JACKCHENPANG/JCY8001_pio/PROJECT_PROGRESS.md

# JCY8001 固件移植进度

> 自动化移植系统 - 用户触发 + 检查点暂停
> 最后更新: 2026-05-04 03:12

---

## 移植策略

**从最小系统开始，逐步移植，每个阶段完整验证**

```
Stage 0 → Stage 1 → Stage 2 → Stage 3 → Stage 4
LED闪烁    MODBUS    EEPROM    SPI+ADC   完整功能
```

---

## 当前状态

**阶段**: `STAGE_4` (业务逻辑)
**状态**: ✅ 代码完成，编译通过（等待硬件验证 J-Link 烧录）
**固件**: `.pio/build/genericSTM32F103RC/firmware.hex` (51KB)
**编译**: ✅ 成功 (RAM: 26.1%/12.8KB, Flash: 6.8%/17.8KB)

---

## 状态说明

| 状态 | 含义 | Agent 行为 |
|---|---|---|
| `PENDING` | 未开始 | 等待用户触发 |
| `IN_PROGRESS` | 进行中 | 继续执行 |
| `WAITING_VERIFY` | 等待验证 | 暂停，通知用户确认 |
| `BLOCKED` | 被阻塞 | 暂停，等待用户处理 |
| `COMPLETED` | 已完成 | 自动进入下一阶段 |

---

## 阶段定义

### Stage 0: LED 闪烁（最小系统）
**目标**: 验证编译链路、烧录、时钟、GPIO
**文件**: `src/main.c`, `platformio.ini`
**状态**: ✅ 完成
**验证标准**:
- [x] `pio run` 编译通过
- [x] 生成 `.elf` 和 `.hex`
- [ ] （有硬件）J-Link 烧录成功
- [ ] （有硬件）LED 以 1Hz 闪烁

### Stage 1: MODBUS 通信
**目标**: 移植 RS485 MODBUS 从机
**源文件**: `Sources/Modbus.c` (915行)
**目标**: `lib/modbus/`
**状态**: ✅ 完成
**验证标准**:
- [x] 编译通过
- [ ] （有硬件）上位机 MODBUS Poll 读取成功
- [ ] （有硬件）寄存器 03H/06H/10H 读写正确

### Stage 2: EEPROM 存储
**目标**: 移植 24CXX EEPROM 驱动
**源文件**: `Drivers/Driver_24CXX.c` (237行), `Drivers/Driver_IIC.c`
**目标**: `lib/eeprom/`
**状态**: ✅ 编译通过，等待硬件验证
**验证标准**:
- [x] 编译通过
- [ ] （有硬件）字节读写正确

### Stage 3: SPI + ADC 测量
**目标**: 移植 SPI 驱动和 DNB11xx 芯片
**源文件**: `Drivers/Driver_SPI1.c` (899行), `Drivers/Driver_DNB11xx.c` (962行)
**目标**: `lib/spi/`, `lib/dnb11xx/`
**状态**: ✅ 编译通过，等待硬件验证
**验证标准**:
- [x] 编译通过
- [ ] （有硬件）DNB11xx枚举成功
- [ ] （有硬件）SPI时序正常

### Stage 4: 完整业务逻辑
**目标**: 移植 RTX 线程 → FreeRTOS 任务
**源文件**: `Threads/*.c` (3310行)
**目标**: `src/tasks/`
**状态**: ✅ 代码完成，编译通过（待硬件验证）
**已实现**:
- FreeRTOS 任务框架 (vTaskModbus, vTaskMeasure)
- Modbus RTU 从机协议 (FC01/02/03/04/05/06/0F/10)
- DNB11xx 枚举和SPI传输接口
- 测量循环: 500ms 定期发送 GetData 命令到 DNB11xx ICs
**待实现**: (全部完成)
**验证标准**:
- [x] 编译通过
- [ ] （有硬件）所有任务运行正常
- [ ] （有硬件）测量功能正常

---

## 进度历史

| 时间 | 阶段 | 操作 | 结果 |
|---|---|---|---|
| 2026-04-29 05:10 | 系统创建 | 初始化自动化系统 | ✅ |
| 2026-04-29 05:14 | STAGE_0 | 编译失败（pio 路径问题） | ❌ |
| 2026-05-01 18:42 | STAGE_0 | 编译通过，J-Link硬件未连接 | ⚠️ 阻塞 |
| 2026-05-01 18:57 | STAGE_0 | 修复platformio.ini include路径 | ✅ |
| 2026-05-01 19:10 | STAGE_1 | 完整Modbus协议实现 | ✅ |
| 2026-05-01 19:18 | STAGE_2 | EEPROM驱动编译通过 | ✅ |
| 2026-05-01 20:33 | STAGE_3 | SPI+DNB11xx驱动编译通过 | ✅ |
| 2026-05-04 05:00 | STAGE_4 | 修复 dnb_ic_count static 链接错误，重新编译成功 | ✅ |
| 2026-05-04 05:00 | STAGE_4 | firmware.hex 生成 (51779 bytes) | ✅ |

---

## 硬件验证阻塞

**问题**: J-Link 未连接
**影响**: 无法执行以下验证:
- JLink核对通讯，验证硬件可靠性
- 用原固件验证基本通讯、设置功能
- 烧录新固件
- 测量功能验证

**解决方案**: 连接 J-Link 调试器后重新执行

---

## 源代码位置

**原始代码**: `/Users/jcy/Projects/JCY8001/firmware/`
**PlatformIO项目**: `/Users/jcy/Projects/JCY8001_pio/`
**固件输出**: `/Users/jcy/Projects/JCY8001_pio/.pio/build/genericSTM32F103RC/firmware.hex`

---

## 注意事项

1. **按阶段逐步验证** - 不一次性移植所有代码
2. **硬件验证需暂停** - 编译通过后等待用户确认
3. **遇到阻塞立即通知** - 不要卡住不动
4. **保留原始注释** - 标注移植来源
