JACKCHENPANG/JCY8001_pio/1e-1.png

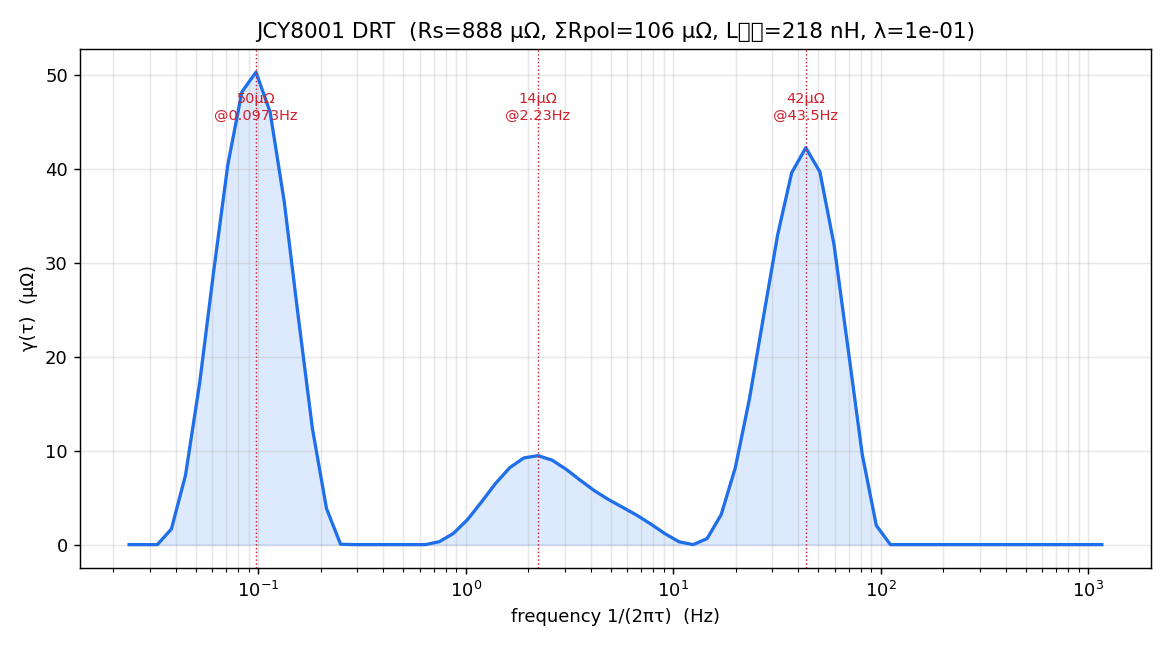
1e-1.png
