JACKCHENPANG/JCY8001_pio/1e-2.png

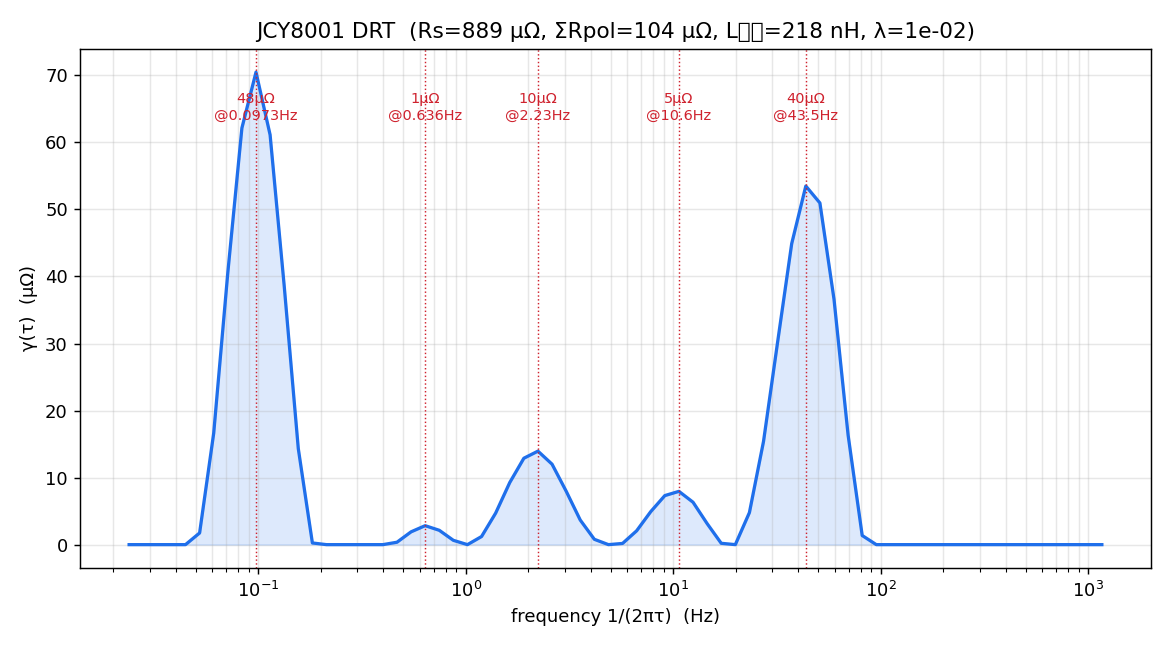
1e-2.png
