JACKCHENPANG/JCY8001_pio/1e-3.png

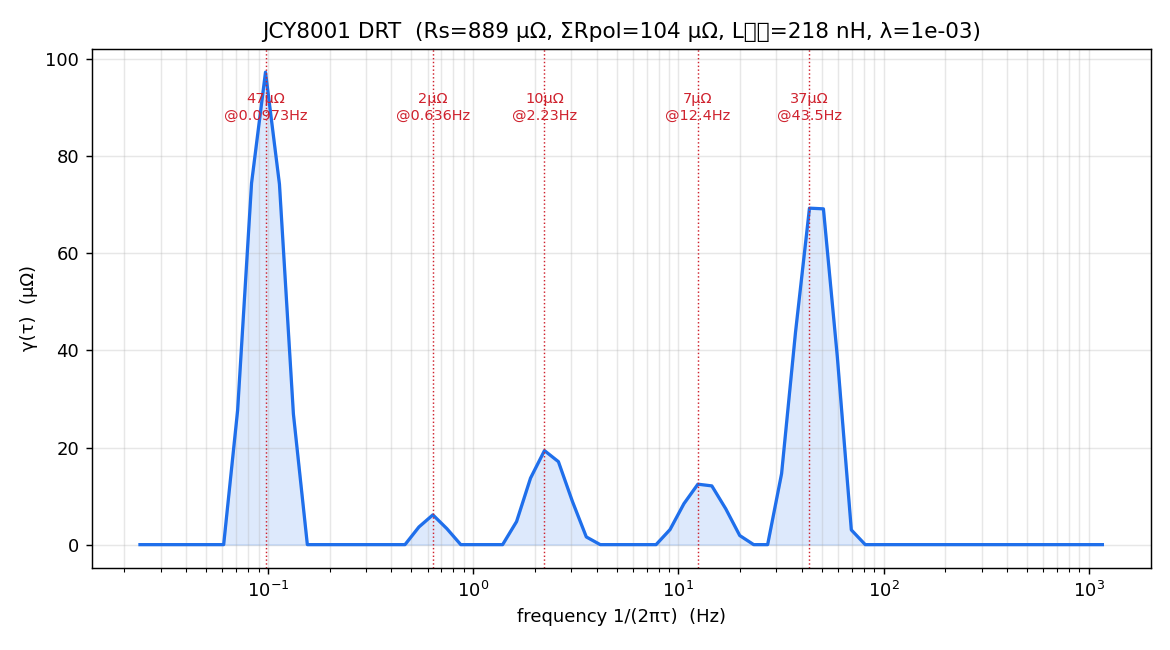
1e-3.png
