JACKCHENPANG/JCY8001_pio/1e-4.png

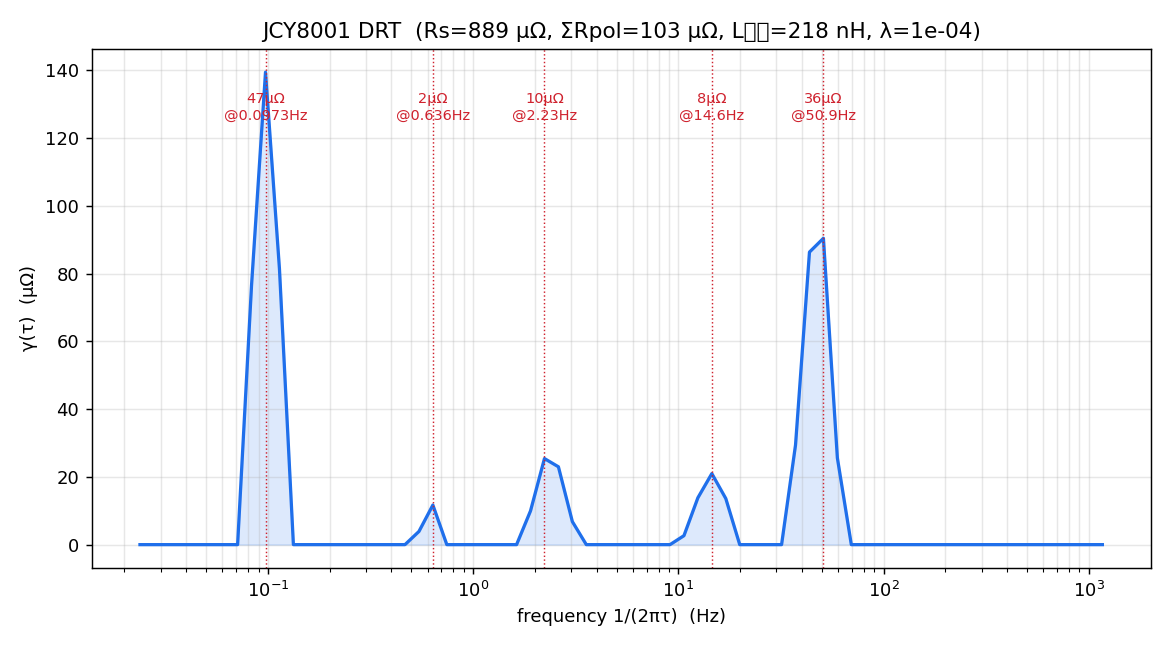
1e-4.png
