JACKCHENPANG/JCY8001_pio/1e-5.png

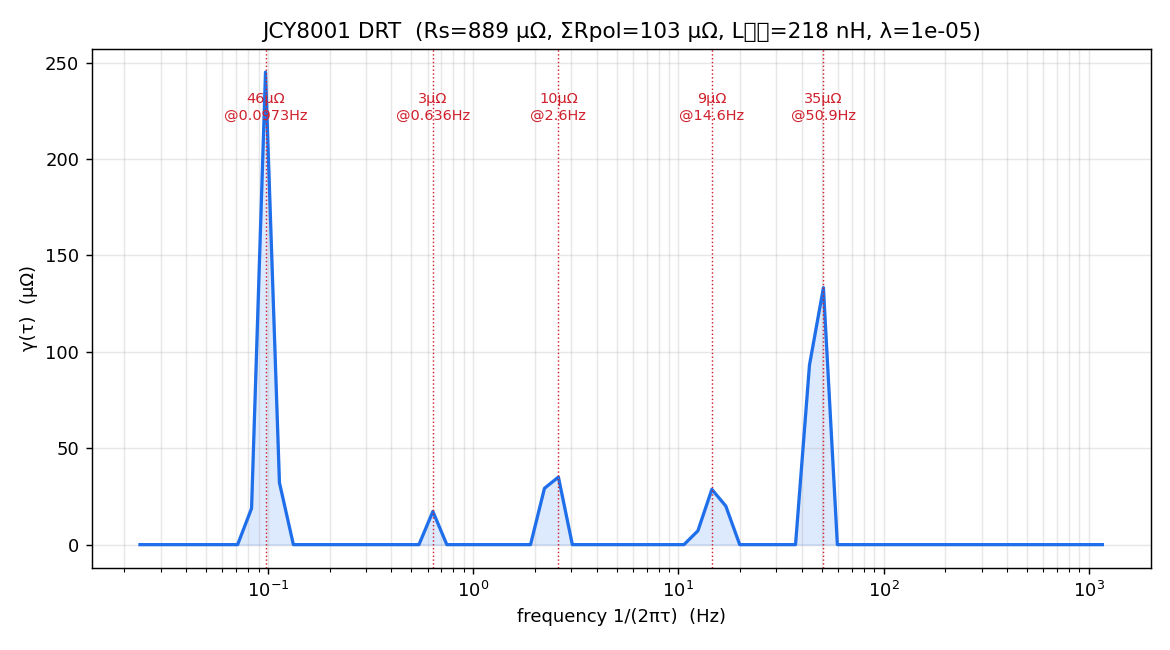
1e-5.png
