JACKCHENPANG/JCY8001_pio/3000.png

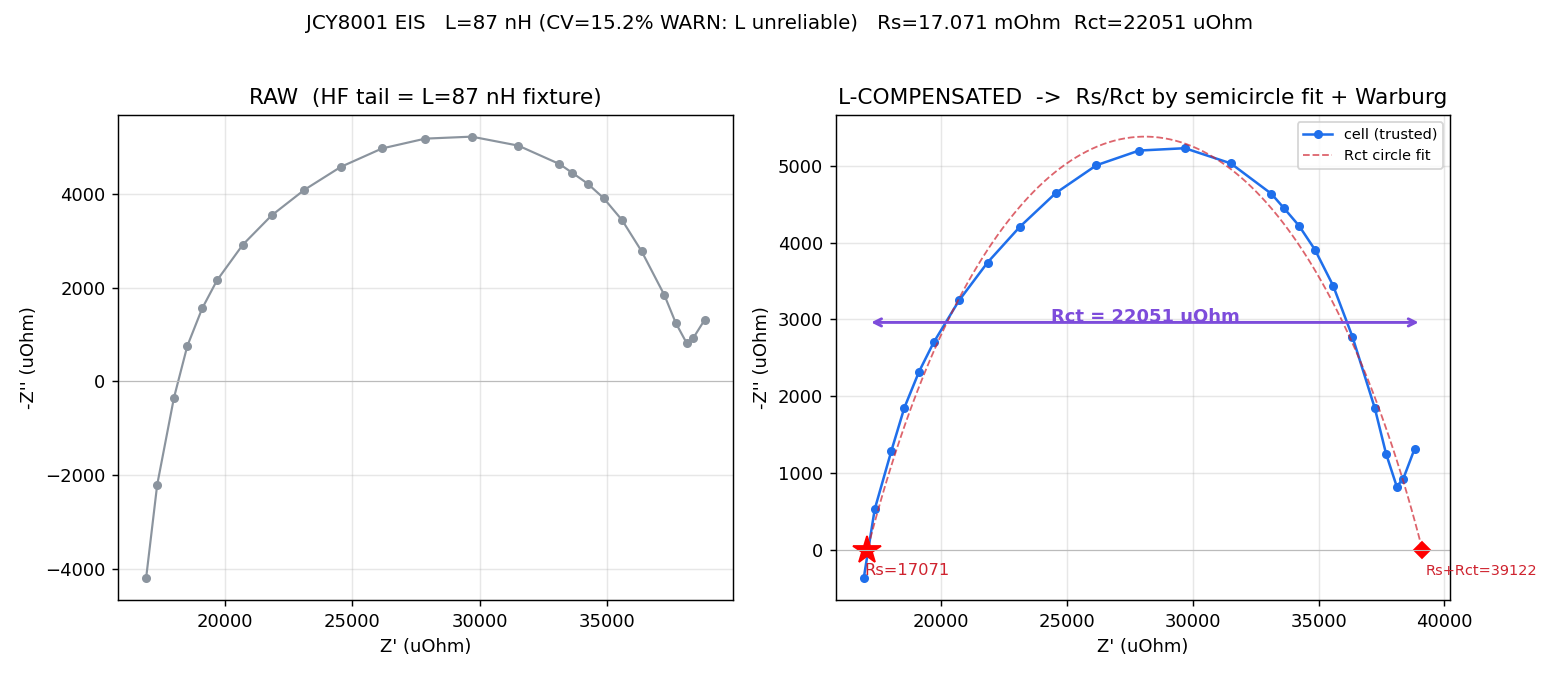
3000.png
