JACKCHENPANG/JCY8001_pio/eis_baseline_1ohm_20260530.png

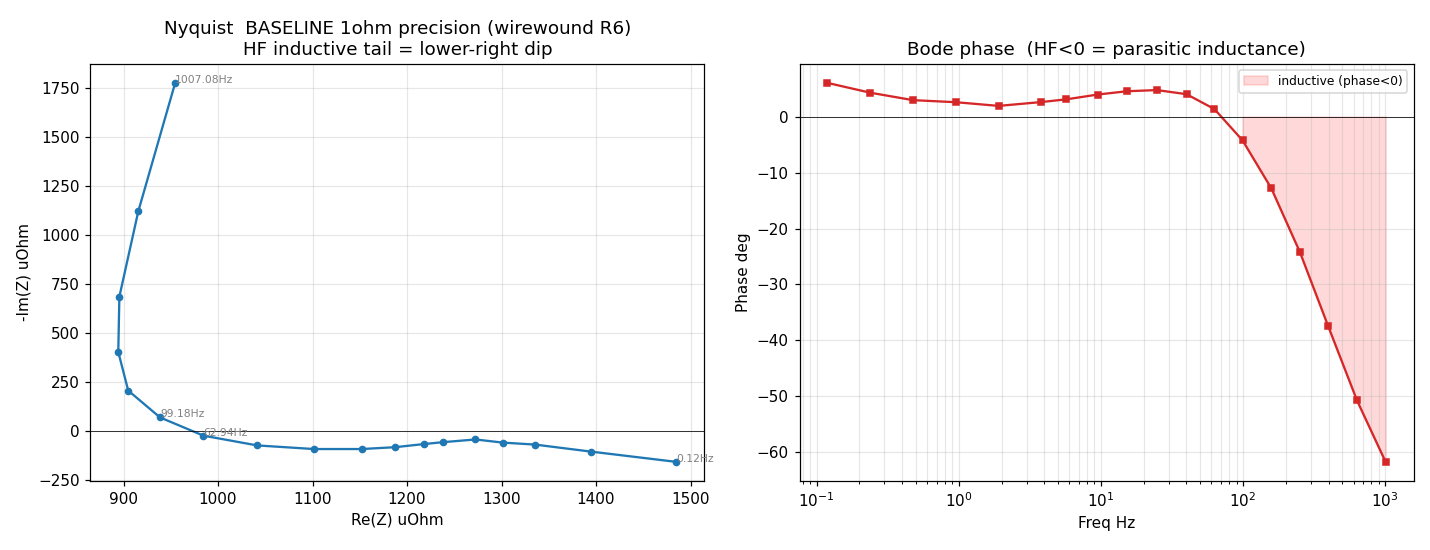
eis_baseline_1ohm_20260530.png
