JACKCHENPANG/JCY8001_pio/eis_compare_20260530.png

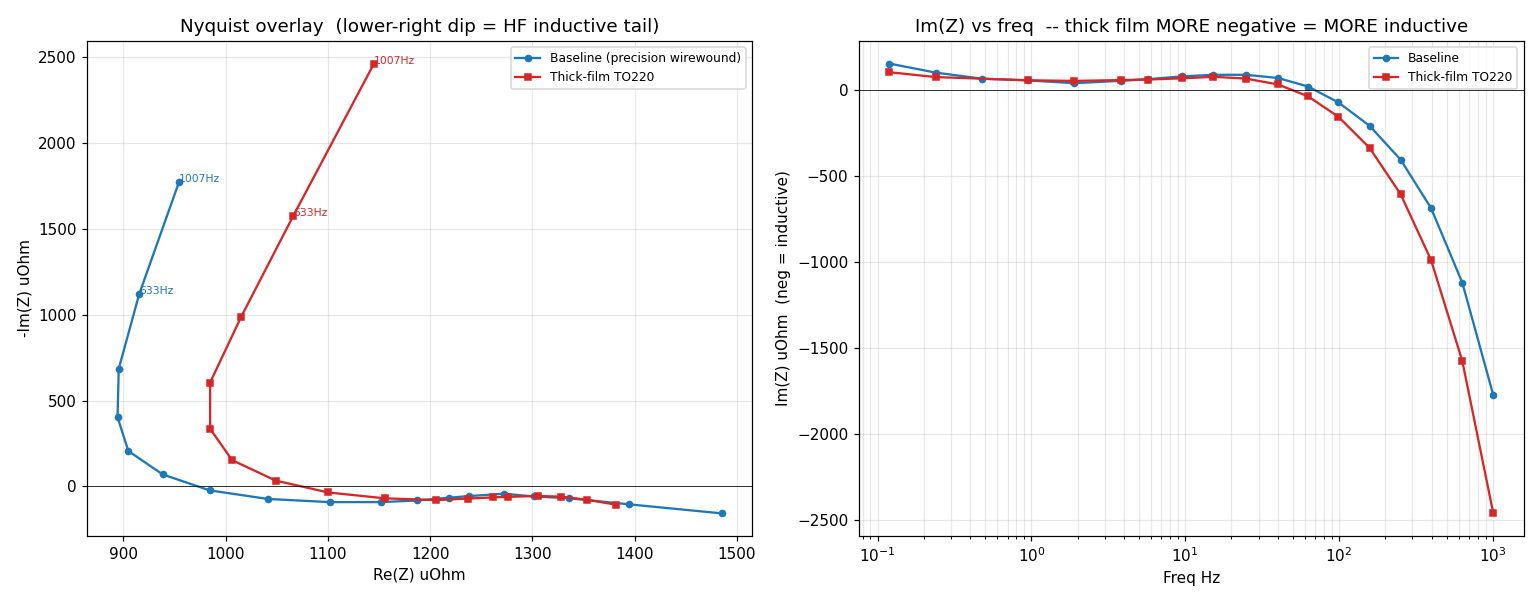
eis_compare_20260530.png
