JACKCHENPANG/JCY8001_pio/kicad/电池阻抗单机.kicad_sch

## KiCad design kicad/电池阻抗单机.kicad_sch (2026-06-08)

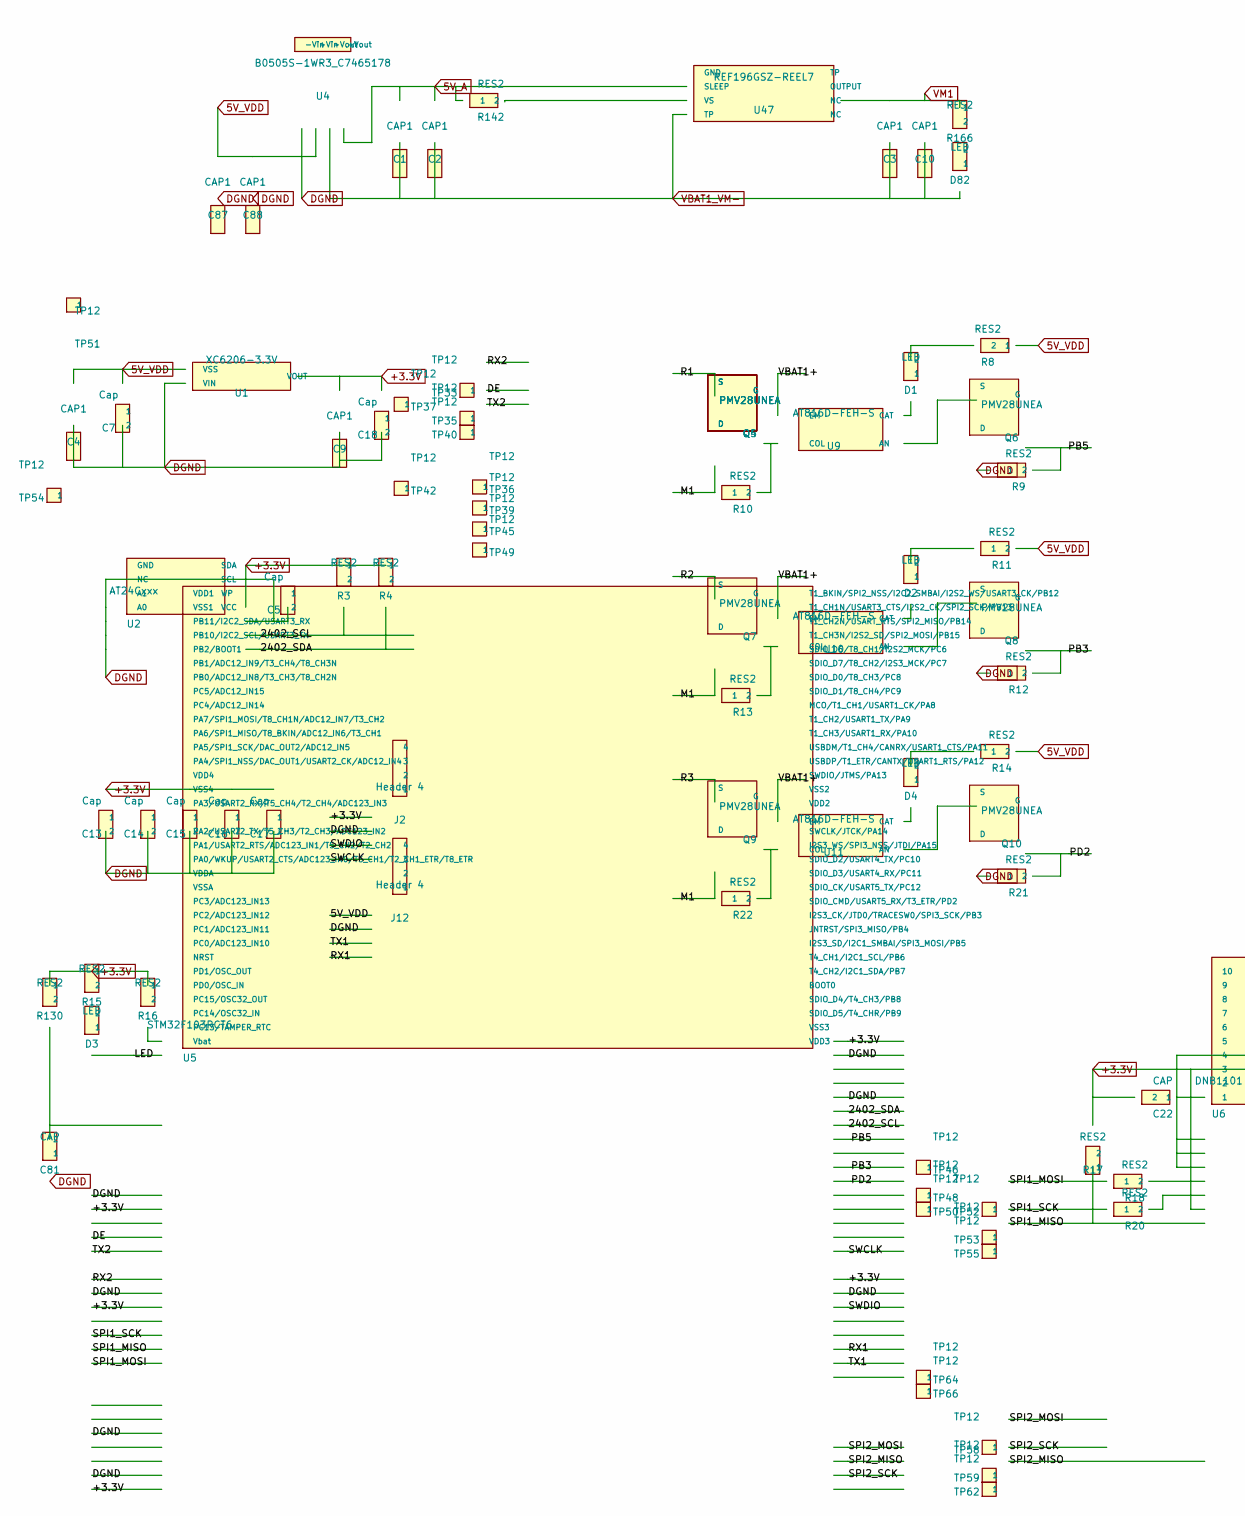
[picture p9: schematic 电池阻抗单机.kicad_sch, part in row 1, column 1]

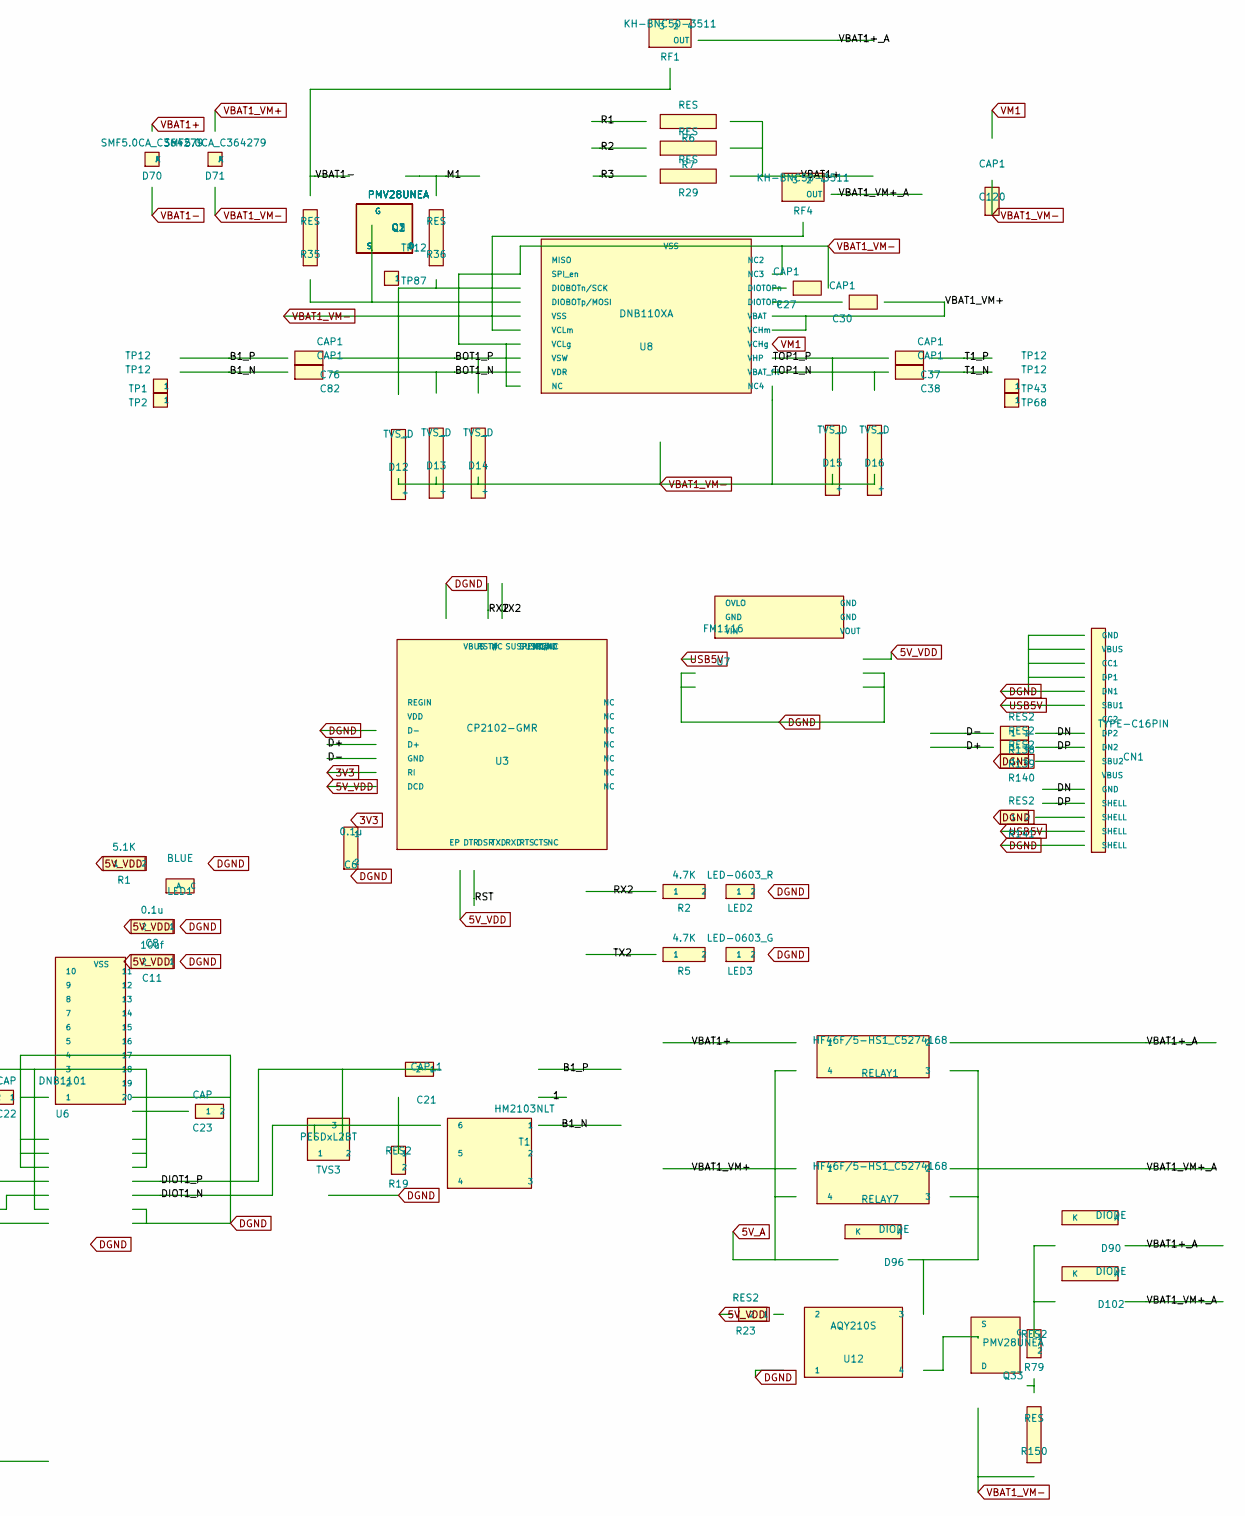
[picture p10: schematic 电池阻抗单机.kicad_sch, part in row 1, column 2]

Parts:
C1, C2, C3, C4, C9, C10, C27, C30, C37, C38, C76, C82, C87, C88, C120: CAP1
C5, C7, C13, C14, C15, C16, C17, C18: Cap
C6, C8: 0.1u
C11: 10uf
C21: CAP_1
C22, C23, C81: CAP
CN1: TYPE-C16PIN
D1, D2, D3, D4, D82: LED
D12, D13, D14, D15, D16: TVS_D
D70, D71: SMF5.0CA_C364279
D90, D96, D102: DIODE
J2, J12: Header 4
LED1: BLUE
LED2: LED-0603_R
LED3: LED-0603_G
Q1, Q2, Q3, Q4, Q5, Q6, Q7, Q8, Q9, Q10, Q33: PMV28UNEA
R1: 5.1K
R2, R5: 4.7K
R3, R4, R8, R9, R10, R11, R12, R13, R14, R15, R16, R17, R18, R19, R20, R21, R22, R23, R79, R130, R138, R139, R140, R141, R142, R166: RES2
R6, R7, R29, R35, R36, R150: RES
RELAY1, RELAY7: HF46F/5-HS1_C5274168
RF1, RF4: KH-BNC50-3511
T1: HM2103NLT
TP1, TP2, TP33, TP35, TP36, TP37, TP39, TP40, TP42, TP43, TP45, TP46, TP48, TP49, TP50, TP51, TP52, TP53, TP54, TP55, TP58, TP59, TP62, TP64, TP66, TP68, TP87: TP12
TVS3: PESDxL2BT
U1: XC6206-3.3V
U2: AT24Cxxx
U3: CP2102-GMR
U4: B0505S-1WR3_C7465178
U5: STM32F103RCT6
U6: DNB1101
U7: FM1116
U8: DNB110XA
U9, U10, U11: AT816D-FEH-S
U12: AQY210S
U47: REF196GSZ-REEL7

Connections:
+3.3V: R3.1, R4.1, R15.1, R16.1, R130.1, U5.18 (VSS4)
DGND: C5.2, C7.2, C9.1, C13.2, C14.2, C15.2, C16.2, C17.2, C18.2, U5.13 (VDDA), U5.16 (PA2/USART2_TX/T5_CH3/T2_CH3/ADC123_IN2)
unnamed: D70.1 (K), D70.2 (A)
unnamed: D71.1 (K), D71.2 (A)
unnamed: Q1.1 (G), Q2.1 (G), Q3.1 (G)
unnamed: Q1.2 (S), Q2.2 (S), Q3.2 (S)
unnamed: Q1.3 (D), Q2.3 (D), Q3.3 (D)
unnamed: Q4.1 (G), Q5.1 (G)
unnamed: Q4.2 (S), Q5.2 (S)
unnamed: Q4.3 (D), Q5.3 (D)
SPI1_MISO: R17.1
VM1: R166.1
