JACKCHENPANG/JCY8001_pio/scripts/verify_stage.py

#!/usr/bin/env python3
"""
JCY8001 移植阶段验证脚本
自动检测当前阶段，运行验证，更新进度
"""

import subprocess
import sys
from pathlib import Path
from datetime import datetime

PROJECT_DIR = Path("/Users/jcy/Projects/JCY8001_pio")
PROGRESS_FILE = PROJECT_DIR / "PROJECT_PROGRESS.md"


def log(msg: str):
    """带时间戳的日志"""
    timestamp = datetime.now().strftime("%Y-%m-%d %H:%M:%S")
    print(f"[{timestamp}] {msg}")


def run_cmd(cmd: str, cwd: str = None) -> tuple:
    """执行命令，返回 (success, output)"""
    try:
        result = subprocess.run(
            cmd, shell=True, cwd=cwd or PROJECT_DIR,
            capture_output=True, text=True, timeout=120
        )
        return result.returncode == 0, result.stdout + result.stderr
    except subprocess.TimeoutExpired:
        return False, "Timeout"
    except Exception as e:
        return False, str(e)


def read_current_stage() -> dict:
    """读取当前阶段状态"""
    content = PROGRESS_FILE.read_text()
    
    # 解析当前阶段
    stage_line = [l for l in content.split('\n') if '`STAGE_' in l and 'PENDING\|IN_PROGRESS\|BLOCKED\|COMPLETED' not in l]
    if not stage_line:
        return {"stage": "STAGE_0_LED_BLINK", "status": "PENDING"}
    
    parts = stage_line[0].split('`')
    stage = parts[1] if len(parts) > 1 else "STAGE_0_LED_BLINK"
    status = parts[3] if len(parts) > 3 else "PENDING"
    
    return {"stage": stage, "status": status}


def update_stage(stage: str, status: str, notes: str = ""):
    """更新阶段状态"""
    content = PROGRESS_FILE.read_text()
    lines = content.split('\n')
    
    # 更新状态行
    for i, line in enumerate(lines):
        if '**阶段**:' in line:
            lines[i] = f"**阶段**: `{stage}`\n"
        elif '**状态**:' in line:
            lines[i] = f"**状态**: `{status}`\n"
    
    # 添加进度历史
    history_start = None
    for i, line in enumerate(lines):
        if '| 时间 | 阶段 |' in line:
            history_start = i + 2  # 跳过表头
            break
    
    if history_start:
        timestamp = datetime.now().strftime("%Y-%m-%d %H:%M")
        new_row = f"| {timestamp} | {stage} | {notes} | {'✅' if status == 'COMPLETED' else '🔄' if status == 'IN_PROGRESS' else '❌' if status == 'BLOCKED' else '⏳'} |\n"
        lines.insert(history_start, new_row)
    
    PROGRESS_FILE.write_text('\n'.join(lines))
    log(f"状态更新: {stage} -> {status}")


def verify_stage_0() -> bool:
    """Stage 0: LED 闪烁验证"""
    log("验证 Stage 0: LED 闪烁...")
    
    # 1. 编译检查
    log("  1/4 编译检查...")
    success, output = run_cmd("pio run")
    if not success:
        log(f"    ❌ 编译失败: {output[:200]}")
        return False
    if "SUCCESS" not in output:
        log(f"    ❌ 编译未成功: {output[:200]}")
        return False
    log("    ✅ 编译成功")
    
    # 2. 检查输出文件
    log("  2/4 检查输出文件...")
    elf = PROJECT_DIR / ".pio/build/genericSTM32F103RC/firmware.elf"
    hex_file = PROJECT_DIR / ".pio/build/genericSTM32F103RC/firmware.hex"
    if not elf.exists() or not hex_file.exists():
        log("    ❌ 输出文件缺失")
        return False
    log("    ✅ 输出文件存在")
    
    # 3. 烧录检查（需要 J-Link 连接）
    log("  3/4 烧录检查（需要硬件）...")
    success, output = run_cmd("pio run --target upload")
    if not success:
        log(f"    ⚠️ 烧录失败（可能未连接硬件）: {output[:200]}")
        # 不返回 False，因为可能没有硬件
    else:
        log("    ✅ 烧录成功")
    
    # 4. 功能验证（需要人工确认 LED 闪烁）
    log("  4/4 功能验证...")
    log("    ⚠️ 需要人工确认 LED 以 1Hz 闪烁")
    
    return True  # 编译通过就算验证成功


def verify_stage_1() -> bool:
    """Stage 1: MODBUS 通信验证"""
    log("验证 Stage 1: MODBUS 通信...")
    
    # 编译检查
    success, output = run_cmd("pio run")
    if not success or "SUCCESS" not in output:
        log(f"❌ 编译失败")
        return False
    
    log("✅ 编译成功")
    log("⚠️ 需要连接 RS485 和上位机进行功能验证")
    
    return True


def verify_stage_2() -> bool:
    """Stage 2: EEPROM 验证"""
    log("验证 Stage 2: EEPROM 存储...")
    
    success, output = run_cmd("pio run")
    if not success or "SUCCESS" not in output:
        return False
    
    return True


def verify_stage_3() -> bool:
    """Stage 3: SPI+ADC 验证"""
    log("验证 Stage 3: SPI+ADC 测量...")
    
    success, output = run_cmd("pio run")
    if not success or "SUCCESS" not in output:
        return False
    
    return True


def verify_stage_4() -> bool:
    """Stage 4: 完整业务验证"""
    log("验证 Stage 4: 完整业务逻辑...")
    
    success, output = run_cmd("pio run")
    if not success or "SUCCESS" not in output:
        return False
    
    return True


STAGE_VERIFIERS = {
    "STAGE_0_LED_BLINK": verify_stage_0,
    "STAGE_1_MODBUS": verify_stage_1,
    "STAGE_2_EEPROM": verify_stage_2,
    "STAGE_3_SPI_ADC": verify_stage_3,
    "STAGE_4_FULL": verify_stage_4,
}


def main():
    """主流程"""
    log("=" * 60)
    log("JCY8001 移植验证系统")
    log("=" * 60)
    
    # 读取当前状态
    current = read_current_stage()
    log(f"当前阶段: {current['stage']}")
    log(f"当前状态: {current['status']}")
    
    # 如果已完成，检查是否需要进入下一阶段
    if current['status'] == 'COMPLETED':
        log("当前阶段已完成，检查下一阶段...")
        # TODO: 自动进入下一阶段
        return 0
    
    # 如果被阻塞，尝试解决
    if current['status'] == 'BLOCKED':
        log("当前阶段被阻塞，需要人工介入")
        return 1
    
    # 执行验证
    verifier = STAGE_VERIFIERS.get(current['stage'])
    if not verifier:
        log(f"❌ 未知的阶段: {current['stage']}")
        return 1
    
    # 更新为进行中
    update_stage(current['stage'], 'IN_PROGRESS', '开始验证')
    
    # 运行验证
    try:
        success = verifier()
    except Exception as e:
        log(f"❌ 验证异常: {e}")
        update_stage(current['stage'], 'BLOCKED', f'验证异常: {str(e)[:50]}')
        return 1
    
    # 更新结果
    if success:
        update_stage(current['stage'], 'COMPLETED', '验证通过')
        log(f"✅ 阶段 {current['stage']} 验证通过")
        return 0
    else:
        update_stage(current['stage'], 'BLOCKED', '验证失败')
        log(f"❌ 阶段 {current['stage']} 验证失败")
        return 1


if __name__ == "__main__":
    sys.exit(main())
