JACKCHENPANG/JCY8001_pio/(commit log)

2026-05-03 Initial JCY8001 PlatformIO firmware commit
    - PlatformIO project with FreeRTOS
    - Modbus RTU (FC01/02/03/04/05/06/0F/10)
    - DNB11xx SPI driver
    - EEPROM 24CXX driver
    - task_measure with 500ms measurement cycle
    - task_modbus for Modbus RTU slave
    Stage 4 complete - awaiting hardware J-Link verification
2026-05-04 v0.1: USART1→USART2 硬件对齐 (CP2102 PA2/PA3)
    - main.c: huart1→huart2, GPIO PA9/10→PA2/3, USART1_IRQ→USART2_IRQ
    - Driver_USART1.c/h: extern huart1→huart2, 实例检查 USART1→USART2
    - task_modbus.c: extern huart1→huart2
    - 编译通过: RAM 26.1%, Flash 6.8% (17880 bytes)
2026-05-04 Fix clock (64→72MHz) and PA3 RX pull (NOPULL→PULLDOWN)
    Bug #1: SystemClock_Config - 64MHz导致USART2 @ 115200 baud误差11%
    - 修复: RCC_PLLSOURCE_HSI + RCC_PLL_MUL9 = 8MHz*9 = 72MHz
    - 影响: 消除Modbus通讯帧错误风险
    Bug #2: HAL_UART_MspInit PA3 RX - 浮空输入易受噪声干扰
    - 修复: GPIO_PULLDOWN确保Modbus空闲时RX为确定低电平
    - 影响: 提高RS485抗干扰能力
    [main.c]
2026-05-04 v1.0: bare-metal Modbus RTU 通讯成功！
    - 纯寄存器操作，绕过 HAL 时钟系统
    - USART2(PA2/PA3) Modbus RTU @ 115200
    - 支持 FC01/03/04/06
    - Flash: 1256B, RAM: 308B
    - main() 开头关闭 CubeF1 SystemInit 错误使能的 HSE+PLL
    - 基于 jcy8001_simple 验证过的方法
2026-05-04 v1.1: SPI1 初始化成功 + Modbus 通讯
    - SPI1 bare-metal 驱动 (CR1=0x0354, SSM/SI/SPE/MSTR/BR=2)
    - 修复: 软件NSS管理避免PA4浮空清除MSTR
    - 修复: GPIOA_CRL mask改为0x0000FFFF保留PA3(USART2_RX)
    - DNB枚举暂时禁用(需解决超时问题)
    - Flash: 1284B, RAM: 308B
    [main.c]
2026-05-04 v1.2: DNB1101 枚举成功, 检测到1个IC
    - DNB1101 Enumerate 命令通过SPI1发送
    - CRC4校验, 菊花链探测9个slot
    - 通道数更新到Modbus寄存器0x3E00=1
    - Flash: 1572B, RAM: 308B
2026-05-04 v1.3: DNB1101 GetData protocol - Init/GetStatus/GetData SPI frames with CRC4, 500ms measurement loop, Modbus registers 0x3E20-0x3E23 for raw data. 1756B flash, 320B RAM. Awaiting battery for DNB powe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
2026-05-29 v2.0: DNB1101 温度+电压读通 (gapless SPI + 从测量芯片 U8/ID=2 读)
    JCY8001 板上有两颗 DNB1101: U6=SPI 网关(ID=1, 只有 TM 无 VM),
    U8=测量(ID=2, VM/TM/ZM)。电芯电压/温度从 U8 读取。
    关键修复:
    - SPI 改无间隙流水线时钟(帧内 SCK 连续, 等效原厂 DMA); 菊花链对带
    间隙的逐字节时钟不响应。
    - 不再 toggle PB2/NSS(芯片用 soft-NSS), 命令间加 ~4ms 间隔。
    - 忠实移植 DNB11xx 协议: CRC4 查表(poly x^3+x^0)、命令位域、head
    前导+0xF0 帧、双发、响应偏移 head+4+(ID-1)*4。
    - 2 颗 IC 链枚举(冷启动分配 U6=1/U8=2, 暖启动确认)。
    - 转换: V=raw/16383*4.8+1.2 (0x3340=V*10000); T=raw*0.0625 (0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
    [jcy8001_smoke.py, main.c, startup_override.c]
2026-05-29 v2.1: Modbus 加固 + 阻抗测量(ZM/EIS)移植
    通讯审查修复:
    - FC01/02/03/04 count 越界保护(防 tx_buf 溢出, 回异常 0x03)
    - 不支持的功能码回异常 0x01(原来静默无响应)
    阻抗测量:
    - FC05 线圈 0x0000 启动 ZM; SetZMFreq+SetZMCurr(EnZM) 发到测量芯片 U8
    - 轮询 SrvReq.BalZMDone, 完成读 Zreal/Zimag/VZM(原始 M/E, 主机换算 Ω)
    - 超时(~6s)自动关 EnZM 恢复 VM, 修掉 ZM 卡住压死电压的坑
    - Modbus: RE 0x3000 / IM 0x3080 / VZM 0x3200 / 频率设置 0x4200
    实测(6V 电源非真实电芯): 命令路径/超时/恢复均 OK; 芯片正确报
    CurrErr/VM-ADCErr(无电芯无法测阻抗)。阻抗数值待真实电芯验证。
    Co-Authored-B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
    [main.c]
2026-05-29 v2.2: FC0F/FC10 + 均衡(Balance) + 参数寄存器
    - FC0F(写多线圈)/FC10(写多寄存器), 带 qty/byteCount 校验
    - 参数寄存器: 采样电阻0x40C0 / 均衡电压0x4100 / 均衡时间0x4140 /
    PWM0x4180 / ZM增益0x4280 (主机 FC03/06/10 读写)
    - 均衡: 线圈0x0040启停, 0x0080模式; SetBalVolt+SetBalCurr(EnBal) 发 U8
    - 实测: 参数读写/多写/线圈回显正确; 均衡与 VM 共存(volt 保持 6V);
    温度+电压全程正常。均衡实际效果与 balVolt 换算待真实电芯标定。
    dev 固件现支持 FC01/02/03/04/05/06/0F/10 + 温度/电压/阻抗/均衡/参数。
2026-05-29 v2.3: 群发地址 + 多通道地址
    - 群发参数 0x4F01/03/04/05/06/07/09 (FC06/10 写全部通道)
    - 群控线圈 0x0F00(ZM)/0x0F01(均衡)/0x0F02(模式) (FC05/0F)
    - 多通道: 本板单测量 IC(U8)=ch1, ch1 base 返回真实数据, ch2~64 返回 0
    - 实测: 群发参数写读回正确, 群控线圈触发正确, 多通道寻址正确
    dev 固件 Modbus 协议层基本完整。待真实电芯验证: 阻抗数值/均衡效果。
2026-05-29 v2.4: ZM 测量模式 (低阻/低频模式) + 协议寄存器
    - 新寄存器 0x4300 ZM模式: 0=普通, 1=低阻低频(强制 LFNS+增益16); 群发 0x4F0A
    - dnb_start_zm 按 jcy_zm_gain 映射 HiPass(1/4/16→00/01/10)
    - 低阻模式一键开 LFNS(压低频噪声)+最大增益; 针对 <1mΩ/<1Hz 随机抖
    - 实测: 模式寄存器读写/群发正确, ZM 正常启动, 温度+电压正常
    注: 随机抖靠 LFNS+平均(1/√N)+大电流+Kelvin; 错频对随机噪声无效。
    平均/电流仍主机侧配, 实际降噪待真实电芯验证。
2026-05-29 v2.5: 阻抗 μΩ 换算 + 64位输出 (对齐 LY8001 上位机)
    上位机 LY8001(JCY5001-LAB) 读 RE0x3000/IM0x3080 为 64位大端有符号、
    /100000=μΩ。原固件发 16位原始 M/E 不兼容, 本次移植原厂换算:
    - lib/dnb_zm: CoeffMapArr(455 double 校准表)+MantMapArr/ExpMapArr,
    Z=mantissa*2^exp*Rext/(VZM*Coeff[idx]), ZI取负
    - VZM=raw*4800/16383+1200, ResisList={10,5,3.33,2.5}
    - 频率索引由 0x4200 的 M/E 反查; 默认频率 0x0746=66.757Hz(表真实项)
    - main.c RE/IM 改 int64, get_reg 0x3000~3003/0x3080~3083 输出64位大端
    - 主机侧单元测试: 索引反查/换算/越界保护通过
    - 实机 temp/volt 正常, RE/IM 按4寄存器返回(6V无电芯=0)
    ⚠️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
2026-05-29 v2.6: 采样电阻 ResisList 改为硬件实际档位 10/5/1Ω
    硬件实际3档采样电阻=10Ω/5Ω/1Ω, 原 ResisList={10,5,3.33,2.5} 不符
    会让阻抗换算差数倍。改为 {10,5,1}+越界钳位。单元测试: 档位
    比值符合 Rext 比。
2026-05-29 v2.7: ZM 用外部电流源 enXCS=1 (修 ZM-ADCErr)
    DNB ZM 必须用外部电流源(数据手册6.13.2), JCY8001 是外部MOSFET+
    采样电阻。原 SetZMCurr enXCS=0(内部)→无电流→ZM-ADCErr。改 enXCS=1
    (bit10)。实机真电芯: 电压3.3V/温度37.5℃正常; ZM 仍 CurrErr——
    因采样电阻需 74HC595 继电器选通(dev 未移植 595 驱动), 待补。
2026-05-29 v2.8: 加采样电阻量程选通 GPIO (PB5/PB3/PD2) + 安全关断
    按用户给的映射: R6=1Ω←PB5, R7=5Ω←PB3, R29=10Ω←PD2, 互斥选通。
    PB3 是 JTDO, SWJ_CFG=010 关JTAG保留SWD(已验证 J-Link 仍可烧)。
    ZM 启动前选通对应采样电阻; 停止时关断三脚(安全, 避免长时间驱动
    可能的充/放电控制脚)。
    ⚠️ 实测: 选通后 ZM 仍 CurrErr+ZM-ADCErr, SrvReq 与未选通相同 →
    PB5 对 ZM 电流回路无影响。ZM 电流回路疑由 U8.VSW 驱动外部 MOSFET
    控制, PB5/PB3/PD2 角色待确认(反推图说充放电, 用户说采样选通, 冲突)。
    拓扑/电流回路待用户或示波器确认, 暂不盲驱。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
2026-05-29 v2.9: 驱动 PB6/PB7 高 → 消除 ZM-ADCErr (进展, 还差CurrErr)
    J-Link 对比原厂 GPIO 发现: 原厂常驱 PB5/PB6/PB7 高(idle ODR=0x..F0)。
    我固件之前只动 PB5、PB6/PB7 没驱。加上 PB6/PB7 高后 SrvReq 从
    0x02C0140A→0x0280040E: ZM-ADCErr(bit8) 消失, 只剩 CurrErr(bit6)。
    PB5/PB6/PB7 改为常驻高(匹配原厂 idle)。
    剩余: CurrErr —— 原厂还把 PB4 配成 AF(疑似定时器/PWM 给ZM激励时钟),
    我固件 PB4 仍输入。J-Link 看不到 AF 波形, 待示波器抓 PB4 频率后复现。
2026-05-29 v2.10: SetZMCurr ZMTimeOut 0x10→1 匹配原厂; 引脚映射厘清
    网表确认控制脚: PB5(pin57)->Q6, PB3(pin55)->Q8, PD2(pin54)->Q10
    (充/放电/待机)。PB4(pin56)=NET_89 未接, PB6/PB7=EEPROM I2C。
    ZM 命令序列(SetZMFreq+SetZMCurr enXCS=外部)+TimeOut=1 已匹配原厂参考。
    GPIO(PB5高)与原厂测量时一致。但 CurrErr 仍在 → 卡在激励电流/VSW
    路径, 待示波器看 U8.VSW(pin3) 波形定位。ZM-ADCErr 已消(PB6/PB7)。
2026-05-30 v2.11: ZM 阻抗全打通 — dev 追平原厂 (RE=934.86μΩ vs 原厂933)
    逻辑分析仪(Saleae+sigrok)抓 SPI + 读 firmware/ 改适配源码定位, 连破三关:
    1. CurrErr: ZM 启动缺 3 条前置命令。dnb_start_zm 补
    SetSrvReqMask(0x75FF)+INIT(0x1009)+SetMode(Normal)。
    实证 SrvReq flags 0x40(bit6 CurrErr)→0x00。
    2. ZM 不完成: 原厂 MeasThread.c 等固定转换时间 ConvTime 到就读
    Zreal/Zimag, 不死等 BalZMDone(本配置该位不置位)。ZM 轮询改
    (BalZMDone || ++zm_cycles>=ZM_CONV_CYCLES(100)) 就读, 检 ZM/VM_ADCErr。
    3. μΩ 数值差 1e5: dnb_zm.c zm_real 少乘 ×100000(主机 value/100000=μΩ)。
    取整前 ×100000.0, long→long lon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
2026-05-30 v2.12: ZM 转换门跟踪 ConvTime + 快速模式 (EIS 全谱扫描提速)
    - conv_target 改为按频率 exp 跟踪实际 ConvTime(=1050*2^(7-exp)ms),
    不再固定过度等待。高频测一点从 ~19s 降到 ~4s(标准)/2.6s(快速)。
    - 新增寄存器 0x4340 ZM 速度: 0=标准(~2x余量,稳), 1=快速(~1.3x余量).
    20点全谱: 旧~10min → 标准~2.2min → 快速~1.4min. 两模式 RE/IM 一致.
    - 低频(0.1Hz)受芯片 ConvTime 物理限制仍需~20-36s/点, 无法再省.
    实测: EIS 1kHz→0.119Hz 20点扫描, Rs(Im过零)=969μΩ, 标准/快速数值吻合.
2026-05-30 v2.13: EIS 扫频工具 + 转换门覆盖寄存器(标定)
    - tools/eis_sweep.py: Modbus 驱动 EIS 全谱扫描(20点 1kHz→0.119Hz),
    优化主机轮询(响应即返回 + 触发后等 zm_done 0→1 握手, 防读残值),
    全谱 fast 模式 ~1.7min.
    - tools/eis_nyquist.py: 画 Nyquist + 求 Rs(虚部过零点). 实测 Rs≈969μΩ.
    - tools/README.md: 用法/寄存器表/踩坑.
    - 0x4360 转换门周期覆盖寄存器(0=自动), 标定最低收敛周期用.
    实测: 高频需 >=5 轮询周期才是新鲜值(<5 读到上次残值), fast 模式 9 周期安全.
2026-05-31 v2.14: 采样电阻校准协议(Modbus+Flash持久化) + DNB自愈
    - 校准: 0x40D0/D1/D2 读写各档(10/5/1Ω)实际阻值(mΩ), 线圈0x0010存Flash末页(0x0803F800).
    开机自动加载, 阻抗换算用标定后Rext消除电阻容差档间误差. dnb_zm ResisList改可写+set/get_resis().
    实测: 写1234→存→复位仍1234, 持久化通过.
    - DNB自愈: 主循环温压原始值连续3次=0判DNB掉枚举→自动重枚举(接触瞬断自恢复), 0x3E30=自愈次数.
    - 3档位实测: 1/5/10Ω均ZM done+flags干净(973/1037/1034μΩ).
2026-05-31 v2.15: OTA 在线升级 (USB/Modbus, Bootloader+App分区)
    - Bootloader (bootloader/boot.c, 1.2KB @0x08000000): 裸机, BKP标志判升级,
    Modbus升级协议(0x7000 id/0x7001 状态/0x7010 长度+CRC32/0x7020 擦除&完成/0x7100 数据块),
    CRC32校验通过才跳App, 防变砖. boot.ld 16KB分区.
    - App重定位 0x08004000: ldscript_app_0x4000.ld + main()设VTOR, platformio.ini指向新ld.
    - App加进Bootloader命令(线圈0x0020): 置BKP_DR1=0xB007+系统复位.
    - 上位机工具 tools/ota_flash.py + bootloader/README.md 协议文档.
    - 硬件实测全通: App→升级模式→传14504字节→CRC32校验OK→跳新App, 全程纯USB不用J-Link.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
2026-05-31 v2.16: 撤销 auto-LFNS (增益与 LFNS 独立)
    - 撤回 v2.15 的"gain>=4 自动开 LFNS": 基于错误理解(以为高增益必须配LFNS).
    - 查手册: 增益(HiPass bits9-8)与 LFNS 独立; gain4/16 需硬件 VHP脚(pin18)上的
    CHP=22µF 电容做高通才工作(本板pin18疑未接CHP→gain4/16不可用, 只gain1可用).
    - 恢复: LFNS 仅由低阻模式 0x4300=1 控制; 0x4280 增益独立只设 HiPass.
2026-05-31 docs: 完整 Modbus 通信协议文档 (全寄存器/功能码/流程, 经实测验证)
2026-05-31 feat: EIS布线/接触补偿工具(AN2001) - 4参数一阶修正Re/Im, 校准+应用
    [eis_wiring_comp.py]
2026-05-31 feat: ZM平均(0x4040) - N次测量取平均压噪
    - 之前0x4040 jcy_zm_avg寄存器有但dnb_start_zm没用上. 现在ZM完成时累加RE/IM,
    达N次输出平均(navg=jcy_zm_avg, 钳1~64). 默认1(不平均,不影响速度).
    - 实测@66Hz: avg=1有975.5离群点(spread~3.4μΩ), avg=4收紧到972.0~972.5(~0.5μΩ),
    avg=8=973.0. 耗时~N倍(avg=1 6.5s/avg=4 15s/avg=8 23s).
    - 用于低频噪声大的点提精度.
2026-05-31 feat(sweep): 固件自主EIS扫频, 上位机一次性下发频点表
    芯片一次只测一频率, 把"逐点切频+测量"循环从上位机搬进固件。
    上位机: FC10 0x4400写频点表(≤64点M/E码) → FC06 0x43C0写点数 →
    FC05线圈0x00C0触发 → 轮询0x3E41已完成点数(边跑边读)或0x3E40=2(完成)
    → 批量读 0x3400/0x3500(RE/IM 64位μΩ) 0x3600(VZM) 0x3640(实际频率码)。
    每点复用单点ZM的平均/转换门/采样电阻逻辑; ADC错记0并继续。
    旧逐点协议不受影响。RAM +1.3KB, 编译通过(5.8%/6.2%)。
2026-05-31 feat(tools): eis_sweep_fw.py 固件自主扫频上位机客户端
    一次性下发频点表(FC10 0x4400)+点数(0x43C0)+触发(0x00C0), 之后轮询
    已完成点数(0x3E41)边跑边取回各点 RE/IM(0x3400/0x3500), 完成(0x3E40=2)结束。
    对照旧 eis_sweep.py(逐点下发逐点取回); 复用同一20点M/E频率表。
2026-05-31 chore: 固件版本号同步 v2.17 + 日期0531 (0x3E02/0x3E04 之前死值0x200/0x504)
2026-05-31 feat(ui): JCY8001 单通道EIS图形上位机 (PyQt5)
    PyQt5+pyqtgraph+pyserial 单文件GUI: 固件自主扫频(频点表下发+边跑边读)
    +单点测量+实时Nyquist/Bode+CSV导出+采样电阻校准对话框。
    Modbus层(CRC/64位μΩ解码/回显校验)+扫频流程经审核与固件一致, py编译通过。
2026-05-31 fix(ui): Modbus读取耐心等到deadline+timeout 0.3→1.0s (台架实测修复)
    原生成代码 _read_exact 一遇空读即break、timeout仅0.3s, 固件ZM测量中单个忙
    窗口>0.3s时第一次轮询0x3E41就超时(实测0/7字节)。改成持续累积读到deadline
    不早退+总等待1.0s/重试4次。台架6点扫频实测通过(RE/IM与eis_sweep_fw一致, 状态→2)。
    [main.py]
2026-05-31 data: EIS基线测试数据(精密1Ω/厚膜TO220对比, 2026-05-30)
    [eis_baseline_1ohm_precision_20260530.csv, eis_thickfilm_1ohm_TO220_20260530.csv]
2026-06-01 fix(modbus): interrupt-driven USART2 RX to stop dropping bytes
    At 8 MHz the bare-metal super-loop spends tens of ms inside one DNB
    measurement burst. RX was polled once per loop iteration, so any byte
    arriving during a burst was lost (single DR, no FIFO) before the next
    poll, corrupting the frame -> CRC fail -> silent drop -> Modbus never
    replied. This was why the upper computer could not connect.
    - main.c: add USART2 RXNE interrupt + 512B ring buffer (ISR reads SR+DR
    so ORE can never wedge RX); super-loop now drains the ring instead of
    reading DR directly. Idle-gap framing unchanged.
    - startup_override.c: extend the vector table with the full STM32F103
    peripheral IRQ table (USART2 =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
    [main.c, startup_override.c]
2026-06-01 feat(tools): auto-fit & compensate fixture inductance in EIS plot
    eis_nyquist.py: least-squares fit of series inductance L from the HF
    points (Z''=wL), subtract jwL from the spectrum to reveal Rs/Rct/Warburg,
    and report a per-point consistency check (CV) as a fixture-health verdict
    (reliable / fair / WARN). Rs now read from the L-compensated curve.
    Flags: --hfmin, --lcal (use external short-circuit L), --no-comp.
    eis_lcal.py: short-circuit fixture calibration -> fits the "true" L from a
    shorted-fixture sweep and writes lcal.txt for eis_nyquist.py --lcal.
    [eis_lcal.py, eis_nyquist.py]
2026-06-01 feat(tools): trim HF mutual-inductance artifact, read Rs from Z'-min
    The -jwL compensation only removes the imaginary tail; the real-part rise
    at the highest frequencies (lead mutual-inductance/coupling artifact)
    remains and curls the compensated Nyquist. Detect it: points above the
    Z'-minimum frequency are fixture artifact -> mark grey/trim, and read Rs
    from the Z' minimum (true real-axis foot) instead of the curled tip.
    --keep-hf disables trimming.
    [eis_nyquist.py]
2026-06-01 feat(tools): semicircle fit for Rs/Rct when arc has no zero-crossing
    After trimming the HF artifact, the trusted arc no longer crosses the
    real axis (lowest-freq point still has -Z''>0), so Rs can't be read from
    a zero crossing. Least-squares circle fit to the Rct semicircle instead:
    left real-axis intercept = Rs, right intercept - Rs = Rct (works for the
    depressed/non-ideal arc, center below axis). Draws the fitted circle and
    both intercepts; falls back to Z'min if the fit has no real intercept.
    [eis_nyquist.py]
2026-06-01 feat(gui): inductance compensation + Rs/Rct semicircle fit in upper computer
    The GUI previously only plotted the raw Nyquist (inductive tail, no
    analysis), so any Rs read off it was biased by the fixture inductance +
    HF mutual-inductance artifact. Port the tools/eis_nyquist.py pipeline into
    the GUI: analyze_eis() fits series L from the HF points, subtracts jwL,
    trims the HF artifact (points above Z'-min), and circle-fits the Rct
    semicircle for Rs (left intercept) and Rct (right-left). Pure-python
    circle fit (3x3 Gauss elimination), no new deps.
    Nyquist now shows: compensated trusted arc, greyed HF-artifact points,
    fitted Rct circle, Rs/Rs+Rct markers, and a live L/CV/Rs/Rct readout.
    "电感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
    [main.py]
2026-06-01 feat(tools): automatic equivalent-circuit (ECM) fit
    eis_ecm.py fits the Randles+CPE+Warburg model
    Z = jwL + Rs + [CPE || (Rct + Zw)]
    to the (HF-artifact-trimmed) spectrum via scipy least_squares with
    relative residuals, extracting L, Rs, Rct, CPE(Q,n), Warburg sigma, and
    derived Cdl_eff / arc peak frequency. Plots measured vs model Nyquist
    with a parameter box.
    On the bench sweep: RMS 1.23%, L=241nH, Rs=846uOhm, Rct=342uOhm,
    Q=26.9 n=0.83 (Cdl~9.5F), sigma=1.95e-4. Needs numpy+scipy.
2026-06-01 feat(gui): equivalent-circuit (ECM) auto-fit in upper computer
    Adds ecm_fit() (Randles+CPE+Warburg via scipy least_squares, lazy import
    with graceful fallback if scipy missing) on top of the existing pure-python
    Rs/Rct semicircle fit. The Nyquist now overlays the ECM model curve and a
    second readout line shows the full circuit: L, Rs, Rct, Cdl, CPE-n,
    Warburg sigma and fit RMS. requirements.txt gains numpy+scipy.
    Verified headless (offscreen): semicircle L=218nH Rs=852 Rct=385, and
    ECM L=241nH Rs=846 Rct=342 Cdl=9.5F n=0.83 sigma=1.95e-4 RMS1.2%.
    [main.py]
2026-06-01 fix(gui): plot ECM model in L-compensated coords to match the blue arc
    The measured Nyquist (blue) is L-compensated (jwL removed) but the ECM
    model overlay was drawn with jwL still in it, so the red curve dived at HF
    and looked inconsistent. Subtract jwL from the model curve too so both are
    in the same (cell-only) coordinates.
    [main.py]
2026-06-01 feat(gui): in-pack consistency test wizard ("不拆包测一致性") + GUI v1.0.0
    New tab guides per-cell in-pack EIS without disassembly:
    - setup: series count N (required), spec (optional), Rct tolerance %,
    RMS-usable threshold % (all configurable)
    - per-cell wizard: auto-drawn pin-header diagram (B0..BN) highlighting the
    current B(k-1)+/B(k)- pair with polarity, prompt, confirm-to-measure
    - each cell: firmware sweep -> analyze_eis + ecm_fit -> RMS gate; if RMS
    exceeds threshold (bad contact/polarity) it asks to re-measure that cell
    - after all N: comparison table (Rs/Rct/Cdl/deviation/status), Rct bar
    chart with batch-median + tolerance bands, out-of-tolerance strings
    highlighte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
    [main.py]
2026-06-01 feat(gui): export in-pack consistency report to CSV
    Adds "导出报告 CSV" button (shown after a run) to the consistency tab.
    Report has a metadata header (time, spec, N, Rct tolerance, RMS threshold,
    median Rct, out-of-tolerance count) then a per-string table (Rs, Rct, Cdl,
    L, RMS, Rct deviation %, OK/超差). UTF-8-BOM so Excel reads Chinese.
    [main.py]
2026-06-01 feat(fw): Modbus on USART1 (J12) for transparent BLE module -> v2.19
    J12 ("UART", SIP4) is wired to USART1 (PA9/PA10), independent of the
    USB/CP2102 Modbus on USART2. Plug a transparent UART-BLE module into J12
    and the phone speaks the same Modbus over BLE (reads firmware-computed
    RE/IM etc.), so all analysis (L-comp/Rs-Rct/ECM/consistency) runs on the
    phone with no MCU change.
    - usart1_init + RXNE ISR + 512B ring (mirror of USART2 path), 115200@8MHz
    - modbus_reply routes to the source port via g_reply_port (1=USART1/BLE,
    2=USART2/USB); super-loop frames both UARTs independently
    - USART1_IRQHandler added to the vector table (IRQ 37)
    Verified on bench: USB Modbus unchanged (fwver 0x0219,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
2026-06-01 feat(tools): DRT (distribution of relaxation times) analysis — backup
    eis_drt.py deconvolves the EIS spectrum into gamma(tau) peaks to separate
    overlapping polarization processes (SEI / charge-transfer / diffusion)
    that a single semicircle/ECM fit lumps together. Non-negative
    Tikhonov-regularized inversion (scipy NNLS, 2nd-difference smoothing),
    fits series-L removed + HF-artifact-trimmed spectrum, free Rs column.
    Reports peak frequency + per-peak resistance (area) and sum Rpol.
    On the bench sweep: Rs~889uOhm, charge-transfer peak ~254uOhm @43.5Hz,
    diffusion peak ~306uOhm @0.1Hz. No HF (SEI) peak because the HF band is
    fixture-inductance/artifact dominated and trimmed — SEI separation n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
    [eis_drt.py]
2026-06-02 fix(eis): support high-impedance cells (tens of mOhm) + no-inductive-tail
    Tools/analysis were tuned for sub-mOhm cells and broke on a high-internal-
    resistance NMC cell (~16-34 mOhm):
    - eis_ecm.py / analysis.js: ECM Rs/Rct bounds were fixed at 5 mOhm -> initial
    guess out of bounds. Now bound auto-scales to the spectrum (>=10 mOhm or
    5x range), so sub-mOhm to tens-of-mOhm both fit.
    - eis_nyquist.py / analysis.js: a high-impedance cell has no HF inductive
    tail, so the L fit returned negative L (garbage compensation). Now L<=0 is
    treated as "no inductive tail, L=0, skip compensation" and the semicircle
    fit still runs on the raw arc.
    Verified on bench NMC cell: Rs~15.7 mOhm, Rct~19 mO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
    [eis_ecm.py, eis_nyquist.py]
2026-06-02 fix(app): toggle sweep-trigger coil 0->1 so sequential sweeps re-fire
    Firmware starts a sweep on the RISING EDGE of coil 0x00C0. device.js only
    wrote 1, so in the in-pack consistency wizard the 2nd cell onward never
    re-triggered (coil already 1, no edge) and read the previous cell's stale
    results. Now write 0 then 1 to make an edge, and wait for the done-count
    to reset before reading. (CLI tools/eis_sweep_fw.py already resets to 0 at
    the end, so it was fine.)
2026-06-02 feat(app): auto sample-resistor range (avoid over-driving high-Z cells)
    Adds device.autoRange(): probes one mid-freq point at 10ohm (gentlest),
    reads |Z| and VZM, then picks the smallest sample resistor (1/5/10ohm)
    that keeps the excitation perturbation I*|Z| <= ~15mV (EIS small-signal),
    maximising current/SNR for low-Z cells while protecting high-Z cells.
    Falls back to 10ohm on probe failure or if even 10ohm over-drives (warns).
    runSweep(opts.auto) probes then sets the gear; index + consistency pages
    now sweep in auto mode and show the chosen gear / current. Adds
    singleZM() helper and VZM register. Motivated by the NMC test where 1ohm
    (~3.9A, ~130mV) under-reported Rct ~15% vs 10ohm (~0.39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
2026-06-02 feat(fw+app): firmware-level auto sample-resistor range -> v2.21
    Auto-range now lives in the firmware (register 0x4380=1). On sweep start
    it runs one probe ZM at 10ohm at a mid-low frequency (~9.5Hz, where |Z| is
    near its max so high-Z cells aren't under-estimated), picks the smallest
    sample resistor keeping excitation I*|Z| <= ~15mV (via dnb_zm_get_resis so
    calibration-aware), locks it for the rest of the sweep. Probe failure ->
    10ohm (safe). Adds ~one fast point (~5-8s), negligible vs the sweep.
    Bench-verified on the NMC cell: started forced at 1ohm, auto-range -> 10ohm
    (samp_res=0), data matches manual 10ohm (Rs~17/Rct~22mOhm).
    App device.js now prefers the firmware auto-range (0x4380=1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
    [main.c]
2026-06-02 feat(app): batch gear-lock in consistency wizard (probe once per pack)
    First cell uses firmware auto-range and captures the picked gear; every
    subsequent cell reuses that locked gear (auto off, samp set) and skips the
    probe. Same-model pack -> probe once, near-zero overhead across N cells.
2026-06-02 feat(app): fast/full scan modes (fewer points for sorting / low-Z cells)
    Two frequency tables in device.js:
    - FULL: 25 pts 7kHz->0.12Hz (research, full Warburg), ~136s
    - FAST: 14 pts 7kHz->1Hz (sorting/consistency), ~56s
    runSweep(opts.mode='fast'|'full'). Bench-verified on NMC: FAST vs FULL give
    the same Rs/Rct (semicircle <0.5%), FAST 2.4x quicker; FAST only drops the
    <1Hz Warburg tail (not needed for Rs/Rct sorting). Low-Z cells use FAST too
    (enough points). Consistency wizard defaults to FAST; index page has a
    fast/full switch. Both tables now start at 5-7kHz so high-Z cells reach the
    HF real-axis intercept + inductive tail.
2026-06-03 fix(app): reject high-freq real-part dip artifacts in EIS analysis
    analyze_eis now drops leading high-freq points (>=200Hz) whose Z' is lower
    than the adjacent lower-freq point -- non-physical lead mutual-inductance
    dips that otherwise masquerade as Z'min and poison the Rs/L fit. Excluded
    from both the inductance LSQ fit and the artifact/trusted split.
    Bench-validated on JCY8001 (3.29V cell): on a run where the 1007Hz point
    dipped, CV went 13%->0.1%, Rs from a false 0.799 to 0.941 mOhm, and the
    Kasa circle fit recovered.
    [main.py]
2026-06-03 fix(app): correct HF artifact rejection (was deleting valid rising HF points)
    The previous rule (re[k] < re[k+1]) wrongly treated a normal spectrum --
    whose Z' rises monotonically as frequency decreases -- as a chain of
    "dips" and skipped the whole high-freq segment, wrecking the L fit
    (seen on a low-Z cell: L=122nH CV=71%).
    New rule only drops leading points that are genuinely invalid: RE<=0
    (dropout / zero reading) or a sharp collapse below 0.6x the adjacent
    lower-freq point (lead mutual-inductance / contact glitch). Normal
    monotonic data is untouched.
    Verified: new board (pt0 read 0,0 dropout) -> drop pt0 only, L=359nH
    CV=1.9% Rs=504uOhm, ECM RMS=0.16%. Prior good 16-pt run unchanged
    (L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
    [main.py]
2026-06-03 fix(fw): USART1 (J12/BLE) back to 115200 to match JDY-10 factory default
    JDY-10 V2.4 manual: factory UART default is 115200bps, NOT 9600. The prior
    v2.20 change to 9600 (BRR=0x0341) was based on a wrong assumption, so a
    stock JDY-10 (115200) would not talk to the board over J12 -> BLE path dead.
    Set USART1 BRR back to 0x45 (115200 @ PCLK2=8MHz). Now any factory JDY-10
    works plug-and-play, no per-module AT+BAUD config. USB/USART2 path
    unaffected.
    Flashed + bench-verified: board still reports FW/V/T over USB Modbus.
    FW_VERSION register left at 0x0221 (cosmetic; logic change only).
    [main.c]
2026-06-03 docs(miniprogram): correct JDY-10 UART baud to 115200 (factory default)
2026-06-03 chore(fw): bump version 0x0221 -> 0x0222 (USART1/BLE 115200 fix)
    [main.c]
2026-06-03 feat(webapp): data-retention backend + per-user(phone) save/history/export
    Deployed to www.jcytest.com: static page /battery-test/ + zero-dep Node
    (node:sqlite) API /battery-api/ behind Bearer token. Records keyed by
    user_phone so multiple operators stay separate; history+CSV by phone/code.
2026-06-03 feat(webapp): validate phone(11 digits)+battery code before save
2026-06-03 feat(webapp): barcode scan to fill battery code + photo capture stored per record
    扫码(BarcodeDetector)填电池码; 拍照压缩上传, 后端存 /battery-photos/, 历史可查看 📷
2026-06-03 feat(webapp): battery internal-resistance range selector (10/5/1Ω -> SAMP_RES)
2026-06-03 feat(webapp): brand (鲸测云) + version v1.0.0 in header/footer
2026-06-04 feat(webapp): 不拆包测一致性 consistency wizard page (pinout guide, per-cell Rct, median/dev/flag, report, save)
2026-06-04 feat(webapp v1.1.0): single-page dual-tab (shared BLE), timer, fast=spread12(to~1Hz fix), RMS quality gate/warn, per-cell live table, freq-range select
2026-06-04 feat(webapp v1.1.3): express mode (8pt 1kHz->7.6Hz, avg=1, ~28s/cell, Rct repeatable 2.6%) as default for sorting
2026-06-04 feat(webapp v1.1.6): drop slow low-freq full-20 mode; express(to 7.6Hz) default, fast-12(to 1Hz) optional
2026-06-04 feat(fw v2.23): expose STM32 96-bit UID as device serial via Modbus regs 0x3E10-0x3E15
2026-06-04 feat(web v1.2.0): device serial from STM32 UID (CRC32->JCY-XXXXXXXX) as primary bind key; phone field -> optional operator; backend device_serial column + serial query/index
2026-06-04 feat(admin): management dashboard at /admin/ — login (user/pass session), record list with serial/code/operator/date filters + paging, Nyquist+photo detail modal, stats cards, CSV export; backend /ad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
2026-06-04 feat(web v1.3.0): SOC/temperature normalization of Rct — OCV-based chemistry auto-detect (LFP/NMC/LTO), OCV->SOC, literature k(SOC)+Arrhenius k(T) curves, normalize Rct to 50%SOC/25C with confidence;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
2026-06-05 feat(fw v2.24 + web v1.3.1): external DS18B20 cell/ambient temp probe — 1-Wire bit-bang (DWT us delay), register 0x3301, 2-phase non-blocking read; web reads 0x3301 (fw>=v2.24), uses cell temp for kT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
2026-06-05 fix(web v1.3.2): live elapsed timer on single-cell page — was writing seconds to hidden dataset attr (invisible). Now a 0.3s interval renders 'phase · Ns' across sweep/retry/warmup
2026-06-05 feat(web v1.3.3): auto frequency-band selection — probe with express, if HF |Z'|>3mOhm (high-impedance NMC/aged cell) auto-extend to low-freq (0.12Hz) band to close the Rct arc; low-Z (LFP) stays exp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
2026-06-05 perf(web v1.3.4): low-freq sweep avg 4->1 — bench-confirmed avg=1 full sweep to 0.12Hz = 102s with Rct=52.8mOhm identical to avg=4@300s. The 3x slowdown was pure averaging waste; accuracy comes from 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
2026-06-05 fix(web v1.3.5): high-impedance cell never completing — measureGood gate failed forever on NMC. (1) circle-fit returns null on Warburg-tailed NMC -> hasRct always false -> infinite retry; now falls b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
2026-06-05 fix(web v1.3.6): low-freq RMS gate 8->12 for high-Z cells — NMC Warburg tail gives rms 7-10% which is normal, gate=8 caused needless retries. E2E BLE test on 53 bench: express(31s)+low-freq(85s)=117s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
2026-06-05 feat(web v1.4.0): 分选快测 sort mode (default) — fast repeatable screening for high-Z cells. SORT band 1kHz->0.95Hz (11pt, ~40s), no arc closure / no Rct fit (which is slow+unstable on NMC Warburg). Rank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
2026-06-05 feat(web v1.4.1): remember/lock gear — on auto range, first cell probes the gear (~14s), then locks it and reuses for subsequent cells (skips ~14s autorange probe -> ~38s/cell). Shows locked gear + 重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
2026-06-05 fw v2.26: ZM per-point timing gate moved from poll-cycle-count to real-time (SysTick 1ms). Discovered DWT CYCCNT does NOT count on this chip (clone) — switched timebase to SysTick ISR (g_ms). Values 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
    [main.c, startup_override.c]
2026-06-05 fw v2.27 (B): enable PLL — HSI/2x16=64MHz (board HSE crystal does NOT oscillate, fell back; used internal HSI). 8x faster MCU. All clock-dependent constants made dynamic from actual SysClock: USART B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
    [main.c]
2026-06-05 revert conv-time reduction (v2.28): base 450ms broke accuracy (Rs read 42.7 vs correct 15mOhm) AND was slower. Back to v2.27 (conv base 1100ms, correct values). KEY finding: the earlier 'wired 2.7s' 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
    [main.c]
2026-06-05 feat(web v1.4.2): 分选快测 SORT band 11pt->8pt [0,2,5,8,12,14,15,16] (1kHz->0.95Hz, ~30s). Keeps enough HF points for Rs fit (Rct/Rs fit fails at <=6pt per bench test); still reaches 0.95Hz for |Z| sort 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
2026-06-05 docs: 2026-06-05 changelog — device serial, admin backend, SOC/temp normalization, cell-temp probe plan, sweep speed/quality optimization (sort mode 8pt ~30s, root cause = DNB ConvTime not BLE), 64MH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
2026-06-05 feat(bootloader): dual-port OTA — bootloader now listens on BOTH USART2(USB wired) AND USART1(JDY bluetooth), replies on receiving port. Enables BLE OTA. Verified end-to-end: wired ~14s, BLE ~229s@MT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
2026-06-05 feat(web v1.5.1): platform-hosted OTA — '升级最新固件' fetches /battery-fw/firmware-latest.bin from server and flashes via BLE (no user file needed); local .bin still available as fallback. otaUpgrade take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
2026-06-05 fix(web v1.5.2): BLE OTA chunk 40->5 regs (19B frame <=MTU23). Phone test failed '写块失败@0' on 89B writes (JDY-10 caps BLE MTU at 23, max ~20B write). 5 regs matches the bleak-verified working size. ~3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
2026-06-05 perf(OTA): length-based framing in bootloader + multi-write big frames over BLE. Bootloader assembles by Modbus frame length (FC10=7+bytecount+2) instead of idle timing -> robust to BLE 20-byte packe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
2026-06-05 feat(web v1.5.4): gray out OTA button when already latest. Backend /fw-latest returns {code,version}; web compares device fw (0x3E02) vs latest on connect+after-OTA, disables btnOtaNet + shows '已是最新 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
2026-06-05 fix(web v1.5.5): firmware version display — low byte was String(decimal) showing 0x27 as '39' (v2.39); now .toString(16) -> '27' (v2.27). Matches 0x0227=v2.27 hex convention. Both connect display and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
2026-06-05 feat(kicad): convert Altium ASCII pcbdoc -> KiCad PCB. User only had ASCII export (not native binary, kicad-cli altium import rejects it); wrote tools/altium_ascii_to_kicad.py (parses |RECORD= Track/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
    [电池阻抗单机.kicad_pcb]
2026-06-08 checkpoint before exposing secondary voltage temperature
    [电池阻抗单机.kicad_sch]
2026-06-08 feat(webapp): show secondary voltage and temperature
2026-06-08 checkpoint before firmware secondary temp voltage
2026-06-08 feat(firmware): expose auxiliary temp voltage
2026-06-08 checkpoint before removing auxiliary voltage
2026-06-08 fix(firmware): keep single voltage input
    [main.c]
2026-06-08 checkpoint before restoring secondary voltage
2026-06-08 feat(jcy8001): read secondary voltage and temperature
2026-06-08 fix(firmware): read guard temp and voltage
    [main.c]
2026-06-10 Revert "fix(firmware): read guard temp and voltage"
    This reverts commit b8cf907b8ffae96be5067d54492123ea3f83d5ef.
    [main.c]
2026-06-10 Revert "feat(jcy8001): read secondary voltage and temperature"
    This reverts commit ad4468061b2a6caf7f290e690228c312ab82e0f0.
    [main.c, main.py]
2026-06-10 Revert "fix(firmware): keep single voltage input"
    This reverts commit f4bf3fb6f9f5dc11835216787e25483a42d6b148.
    [main.c]
2026-06-10 Revert "feat(firmware): expose auxiliary temp voltage"
    This reverts commit 2f903279d5ec1a51a31c71c7b99eb49af33b93c0.
    [main.c]
2026-06-10 fix(fw v2.32): autorange picks 1Ohm gear for low-Z cells
    autorange_pick probed at 10Ohm (gentlest) then defaulted to 10Ohm when
    the probe signal was weak (s2<=0) — but a weak 10Ohm probe signal is
    exactly what a sub-mOhm cell produces, so low-internal-resistance cells
    got stuck on the LEAST sensitive 100mOhm gear.
    Fix: |Z| < 3mOhm (s2 < 9e6 uOhm^2, incl. weak/0 probe) -> directly pick
    the most sensitive 1Ohm(~1mOhm) gear (high current, strong signal).
    Verified on bench: ~1mOhm cell now locks gear=2 (1Ohm) instead of 0 (10Ohm).
    [main.c]
2026-06-10 feat(fw v2.33): JDY auto-rename to JCY-<UID> at boot for multi-board ID
    Two JCY8001 boards both advertise as 'JDY-10-V2.5' -> indistinguishable
    when scanning in the same room. At boot MCU sends AT+NAMEJCY-XXXX (XXXX =
    STM32 96-bit UID low 16 bits, hex) to the JDY-10 on USART1; JDY persists
    the name. Verified: J-Link board (UID ff39) now broadcasts 'JCY-FF39'.
    Includes v2.32 autorange fix.
    [main.c]
2026-06-10 feat(fw v2.34): jdy_rename sends AT+RESET after AT+NAME
    BLE OTA upgrade left the JDY not re-advertising with its new name (AT+NAME
    alone needs the module to reset to re-broadcast) — required a manual power
    cycle. Add AT+RESET after AT+NAME so the JDY cleanly resets and re-advertises
    as JCY-XXXX right after OTA, no manual power cycle. Costs ~1.5s extra JDY
    reset per power-on. Includes v2.33 rename + v2.32 autorange fix.
    [main.c]
2026-06-10 feat(fw v2.35): DNB self-heal also triggers on GenStat==0xFFFF
    Self-heal only re-enumerated when temp_raw==0 AND volt_raw==0. But the
    real dropped-enumeration state seen on a board after connecting a cell is
    temp=0 + volt=railed(0xEA60, NOT 0) + GenStat=0xFFFF (MCU reads DNB MISO
    floating = SPI dead). Old condition missed it (volt!=0) so DNB stayed dead
    needing a manual cold start (selfheal_cnt stayed 0). Now trigger when
    temp_raw==0 AND (volt_raw==0 OR gs_hi==0xFFFF) -> auto re-enumerates this
    railed/dead state too. Verified on bench: JCY-0054 GenStat 0x0280 (fine),
    JCY-FF39 GenStat 0xFFFF (was stuck, self-heal now catches it).
    [main.c]
2026-06-10 fix(fw v2.35): self-heal trigger on GenStat==0xFFFF directly (temp_raw is 0xFFFF not 0 when DNB floats)
    First v2.35 attempt used temp_raw==0 in the condition, but when the DNB
    MISO floats the GetData returns 0xFF -> decoded temp_raw = 0xFFFF (NOT 0;
    only the scaled jcy_temp displays 0). So condition never matched.
    Trigger directly on GenStat high word == 0xFFFF (cleanest DNB-no-response
    signal). Bench-verified: FF39 self-heal now fires (selfheal_cnt 1->5
    climbing). NOTE: software re-enum does NOT recover a hard-dropped DNB
    (GenStat stays 0xFFFF) - needs physical cold start - but self-heal now
    correctly detects + retries (recovers soft/transient contact drops).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
    [main.c]
